DCoJA/yatagarasu-red/README.md

# yatagarasu-red

Kicad file of the shield which is to run ArduPilot on 96Boards.

## File list

Kicad project file

* yatagarasu-fit.pro

Schematic

* [yatagarasu-fit.pdf](./yatagarasu-fit.pdf)

## Videos on youtube of the first flight

* Used DragonBoard 410C (Snapdragon 410E).

### In English

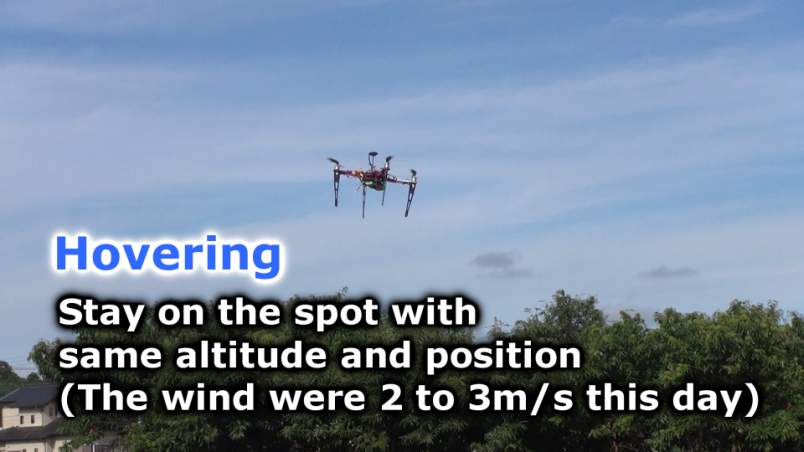
[picture p1: images/yatagarasu4-music-en.png]
(https://www.youtube.com/watch?v=AuMpDXEWkLk)


### In Japanese

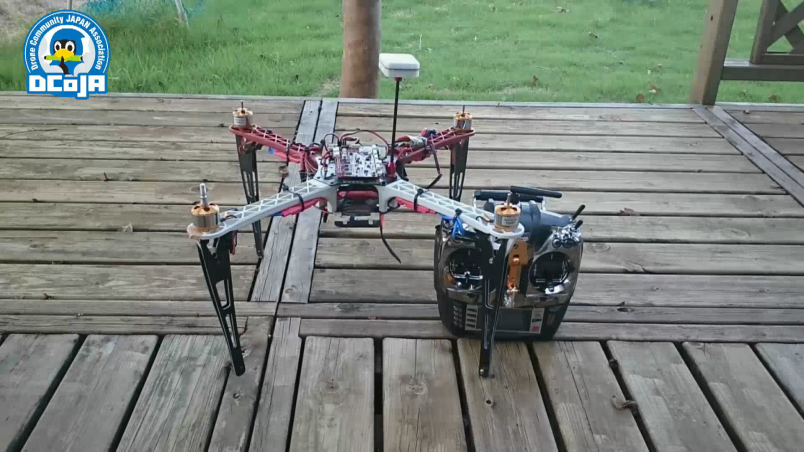
[picture p2: images/yatagarasu4-music-jp.png]
(https://www.youtube.com/watch?v=8HEuyZ0l6P4)


## Images

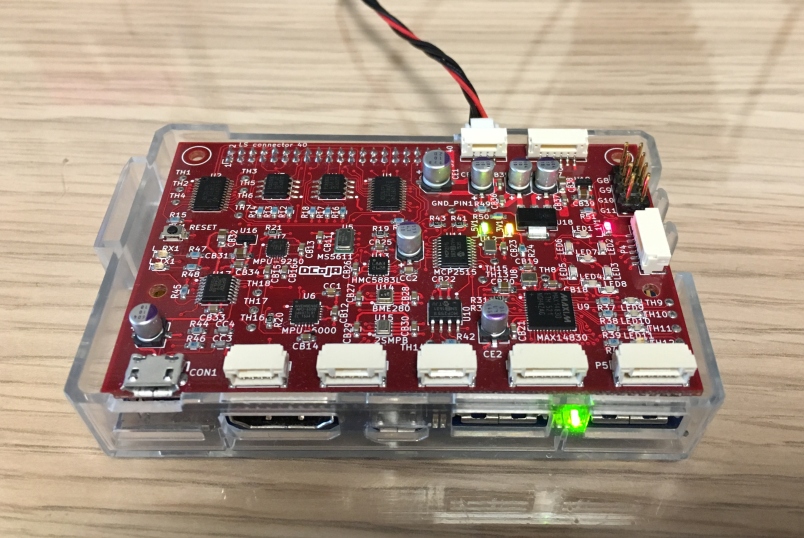
[picture p3: images/yatagarasu-red-LED-mod-804.jpg]
powered-on

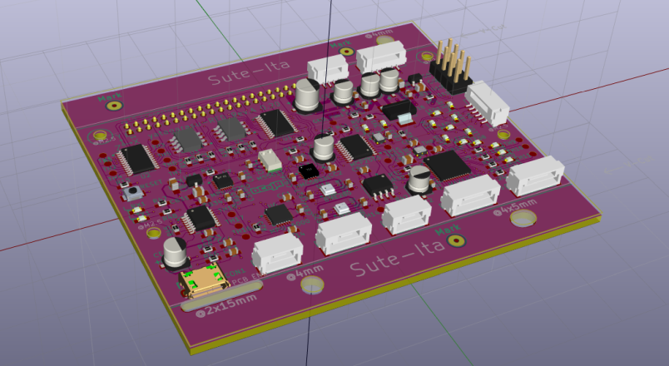
[picture p4: images/3d-top-20170331-25-s.png]
3D-model-top-kicad

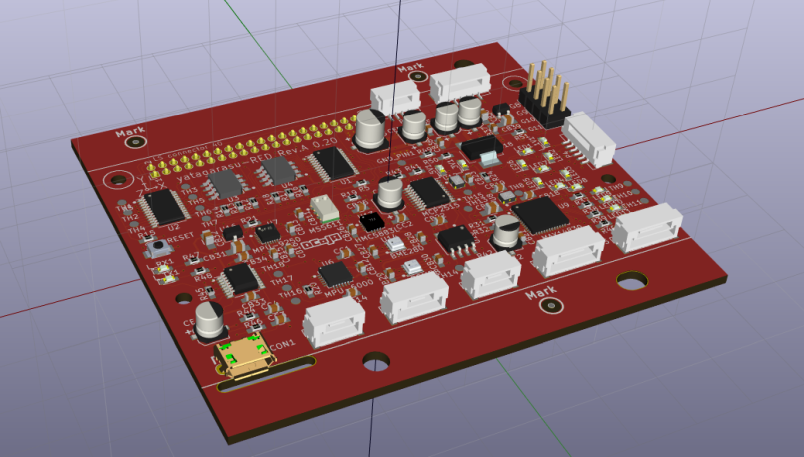
[picture p5: images/3d-top-20170331-25-real-s.png]
3D-model-top-details

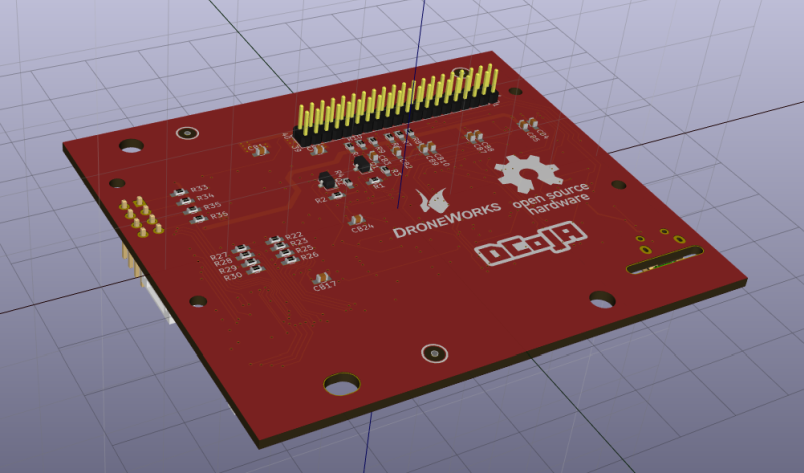
[picture p6: images/3d-bottom-20170331-25-s.png]
3D-model-bottom-kicad

  
PCB Layout  
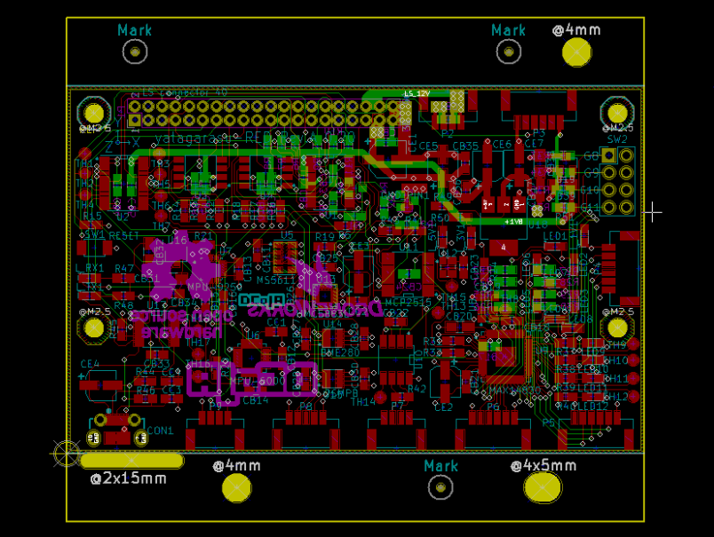
[picture p7: images/kicad-pcbnew-screen-s.png]
kicad-pcbnew

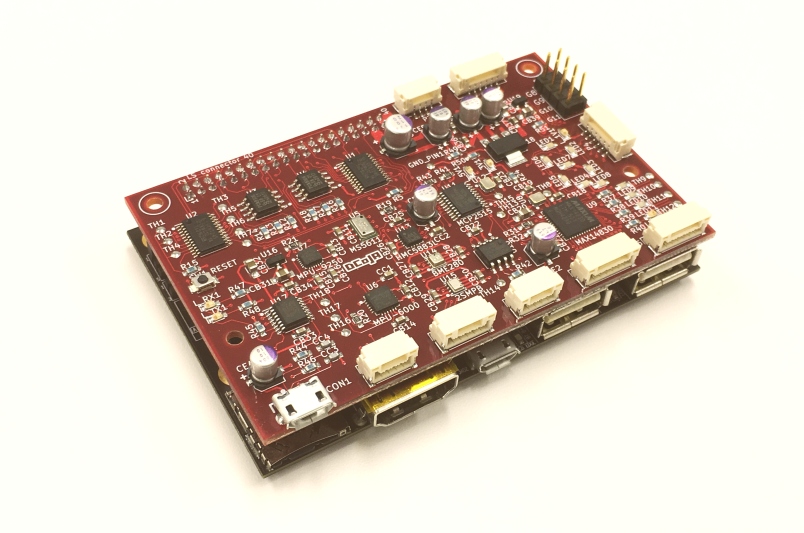
[picture p8: images/yatagarasu-top-front-left-s.jpg]
PCB-TOP-left

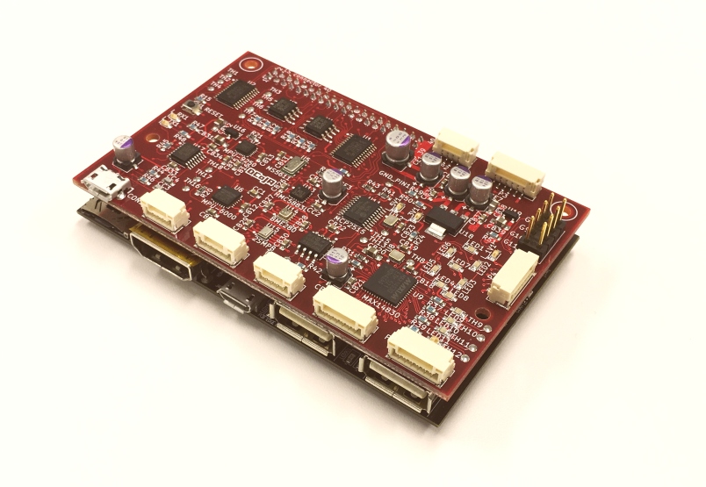
[picture p9: images/yatagarasu-top-front-right-s.jpg]
PCB-TOP-right
