DCoJA/yatagarasu-red/images/3d-bottom-20170331-17-s-s.png

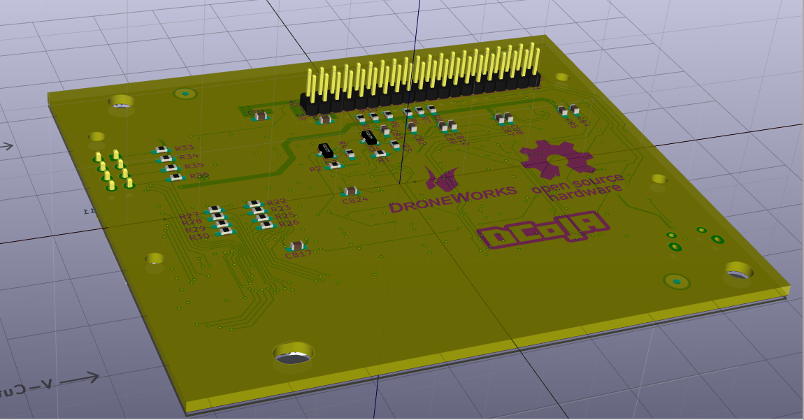
images/3d-bottom-20170331-17-s-s.png
