DCoJA/yatagarasu-red/images/3d-top-20170331-23-1-s-s.jpg

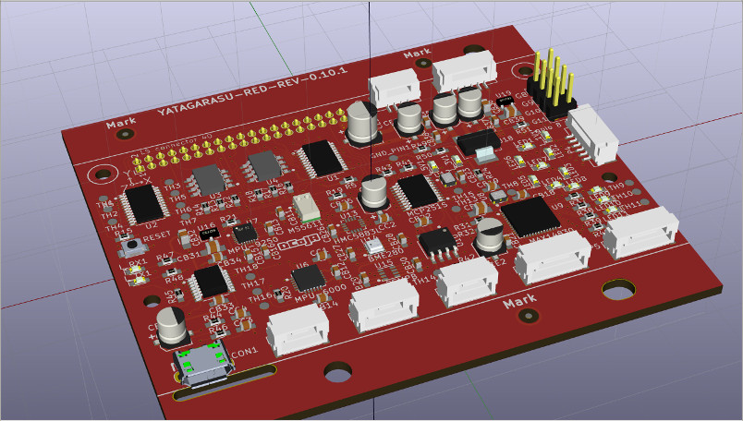
images/3d-top-20170331-23-1-s-s.jpg
