DCoJA/yatagarasu-red/images/yagarasu-red-front-board-g-1-s.jpg

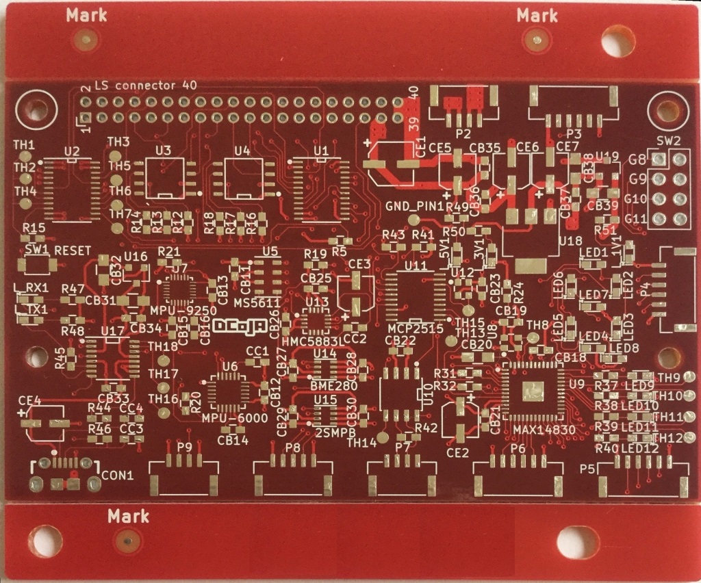
images/yagarasu-red-front-board-g-1-s.jpg
