DCoJA/yatagarasu-red/Console.sch

## KiCad design Console.sch (2017-12-15)

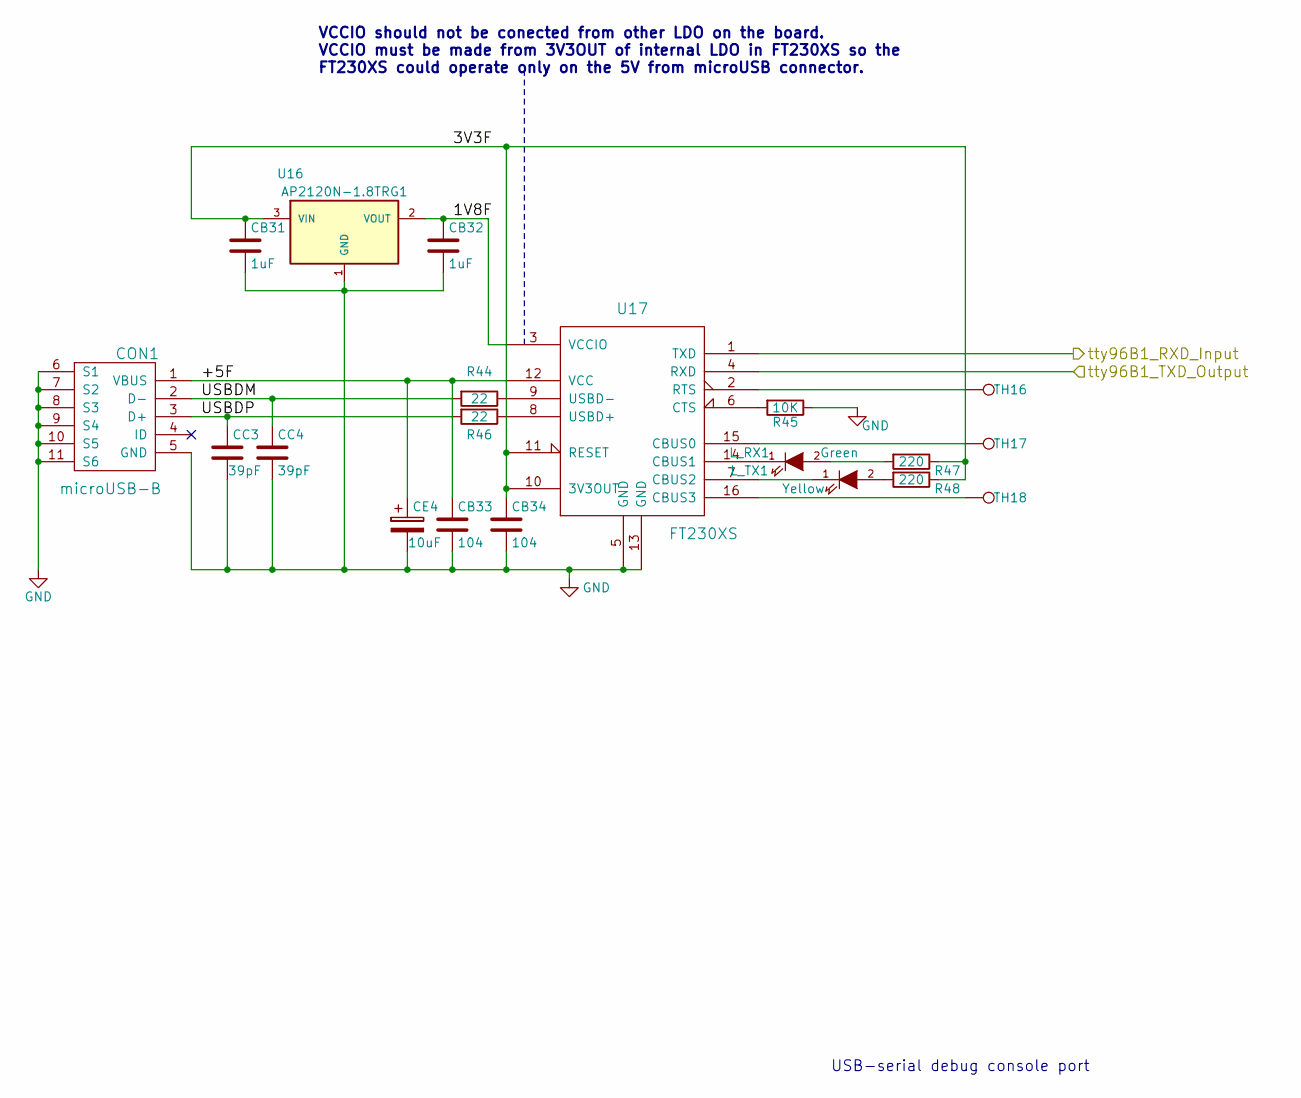
[picture p21: schematic Console.sch]

Parts:
CB31, CB32: 1uF; C_0805_Hand_droneworks
CB33, CB34: 104; C_0603_Hand_droneworks
CC3, CC4: 39pF; C_0603_Hand_droneworks
CE4: 10uF; CP_OS-CON-A5_droneworks
CON1: microUSB-B; USB_Micro-B_Amphenol-10118194-0001LF-C_droneworks
L_RX1: Green; LED_0603_1608mm_droneworks
L_TX1: Yellow; LED_0603_1608mm_droneworks
R44, R46: 22; R_0603_Hand_droneworks
R45: 10K; R_0603_Hand_droneworks
R47, R48: 220; R_0603_Hand_droneworks
TH16: RTS; SolderWirePad_single_1mmPad_droneworks
TH17: CBUS0; SolderWirePad_single_1mmPad_droneworks
TH18: CBUS3; SolderWirePad_single_1mmPad_droneworks
U16: AP2120N-1.8TRG1; SOT-23
U17: FT230XS; SSOP-16_3.9x4.9mm_Pitch0.635mm_droneworks

Connections:
1V8F: CB32.1, U16.2 (VOUT), U17.3 (VCCIO)
3V3F: CB31.1, CB34.1, R47.1, R48.1, U16.3 (VIN), U17.10 (3V3OUT), U17.11 (RESET)
+5F: CB33.1, CE4.1, CON1.1 (VBUS), U17.12 (VCC)
GND: CB31.2, CB32.2, CB33.2, CB34.2, CC3.2, CC4.2, CE4.2, CON1.5 (GND), CON1.6 (S1), CON1.7 (S2), CON1.8 (S3), CON1.9 (S4), CON1.10 (S5), CON1.11 (S6), R45.1, U16.1 (GND), U17.5 (GND), U17.13 (GND)
unnamed: L_RX1.1 (K), U17.14 (CBUS1)
unnamed: L_RX1.2 (A), R47.2
unnamed: L_TX1.1 (K), U17.7 (CBUS2)
unnamed: L_TX1.2 (A), R48.2
unnamed: R44.1, U17.9 (USBD-)
unnamed: R45.2, U17.6 (CTS)
unnamed: R46.1, U17.8 (USBD+)
unnamed: TH16.1, U17.2 (RTS)
unnamed: TH17.1, U17.15 (CBUS0)
unnamed: TH18.1, U17.16 (CBUS3)
USBDM: CC4.1, CON1.2 (D-), R44.2
USBDP: CC3.1, CON1.3 (D+), R46.2
tty96B1_RXD_Input: U17.1 (TXD)
tty96B1_TXD_Output: U17.4 (RXD)

Notes on the sheet:
VCCIO should not be conected from other LDO on the board. VCCIO must be made from 3V3OUT of internal LDO in FT230XS so the FT230XS could operate only on the 5V from microUSB connector.
USB-serial debug console port
