DCoJA/yatagarasu-red/NCP1117s.sch

## KiCad design NCP1117s.sch (2017-12-15)

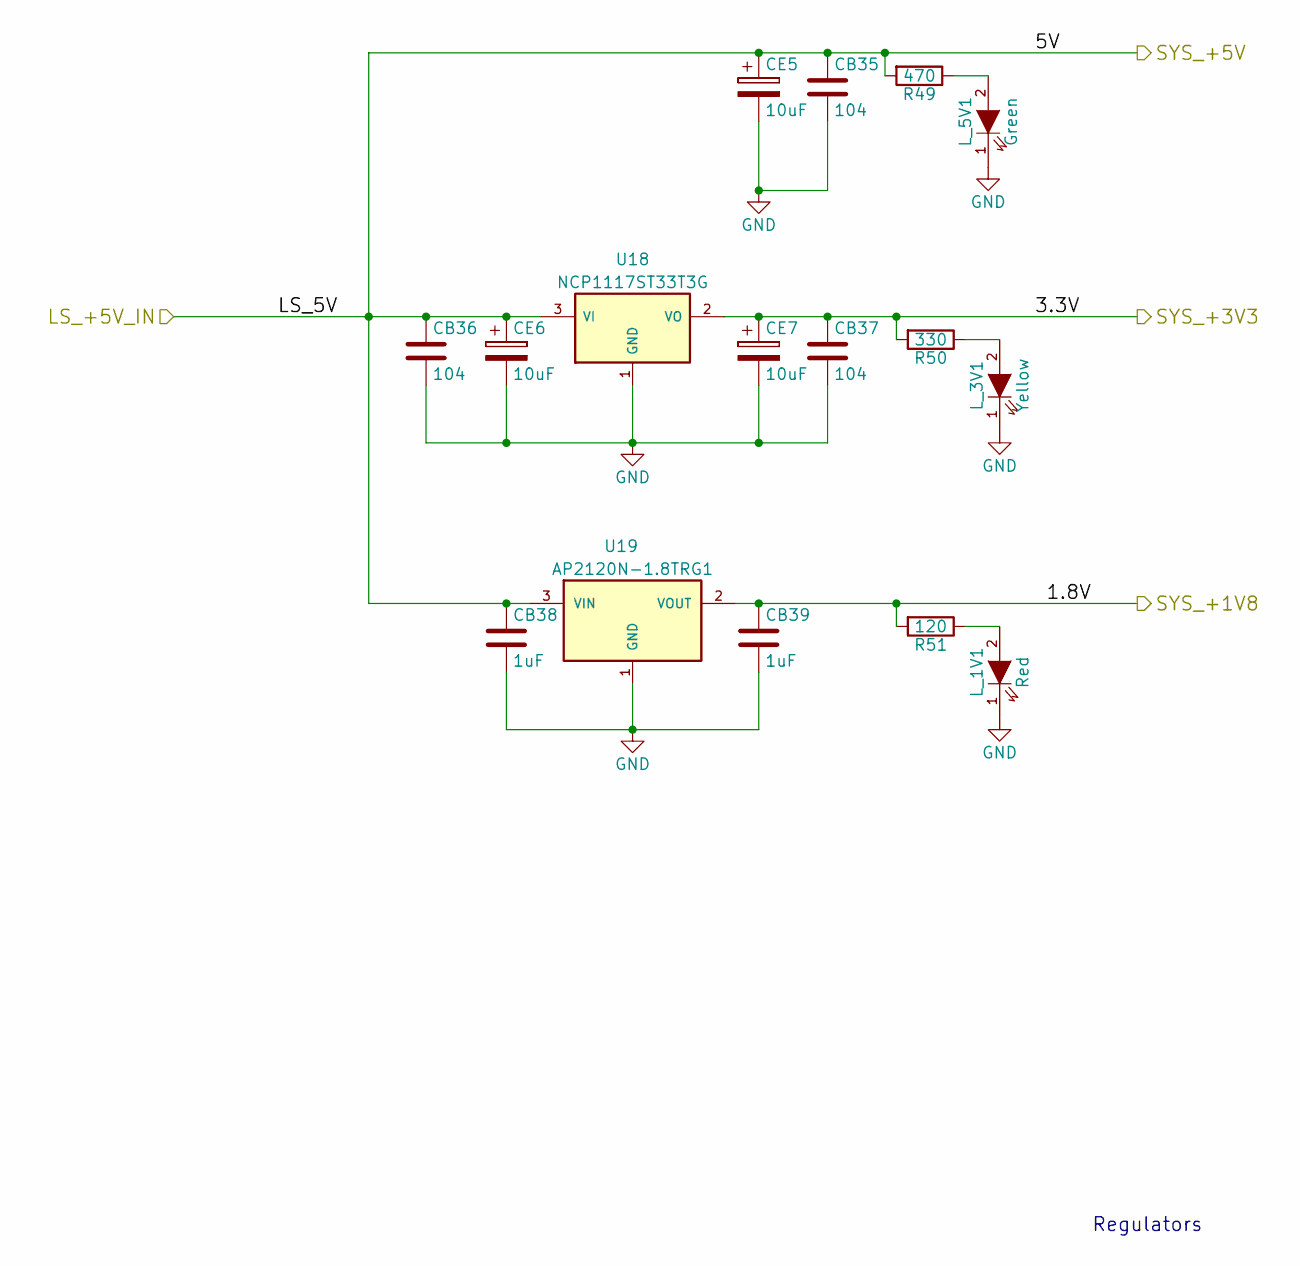
[picture p22: schematic NCP1117s.sch]

Parts:
CB35, CB36, CB37: 104; C_0603_Hand_droneworks
CB38, CB39: 1uF; C_0805_Hand_droneworks
CE5, CE6, CE7: 10uF; CP_OS-CON-A5_droneworks
L_1V1: Red; LED_0603_1608mm_droneworks
L_3V1: Yellow; LED_0603_1608mm_droneworks
L_5V1: Green; LED_0603_1608mm_droneworks
R49: 470; R_0603_Hand_droneworks
R50: 330; R_0603_Hand_droneworks
R51: 120; R_0603_Hand_droneworks
U18: NCP1117ST33T3G; SOT-223
U19: AP2120N-1.8TRG1; SOT-23

Connections:
1.8V: CB39.1, R51.2, U19.2 (VOUT)
3.3V: CB37.1, CE7.1, R50.2, U18.2 (VO)
5V: CB35.1, CB36.1, CB38.1, CE5.1, CE6.1, R49.2, U18.3 (VI), U19.3 (VIN)
GND: CB35.2, CB36.2, CB37.2, CB38.2, CB39.2, CE5.2, CE6.2, CE7.2, L_1V1.1 (K), L_3V1.1 (K), L_5V1.1 (K), U18.1 (GND), U19.1 (GND)
unnamed: L_1V1.2 (A), R51.1
unnamed: L_3V1.2 (A), R50.1
unnamed: L_5V1.2 (A), R49.1

Notes on the sheet:
Regulators
