DCoJA/yatagarasu-red/can.sch

## KiCad design can.sch (2017-12-15)

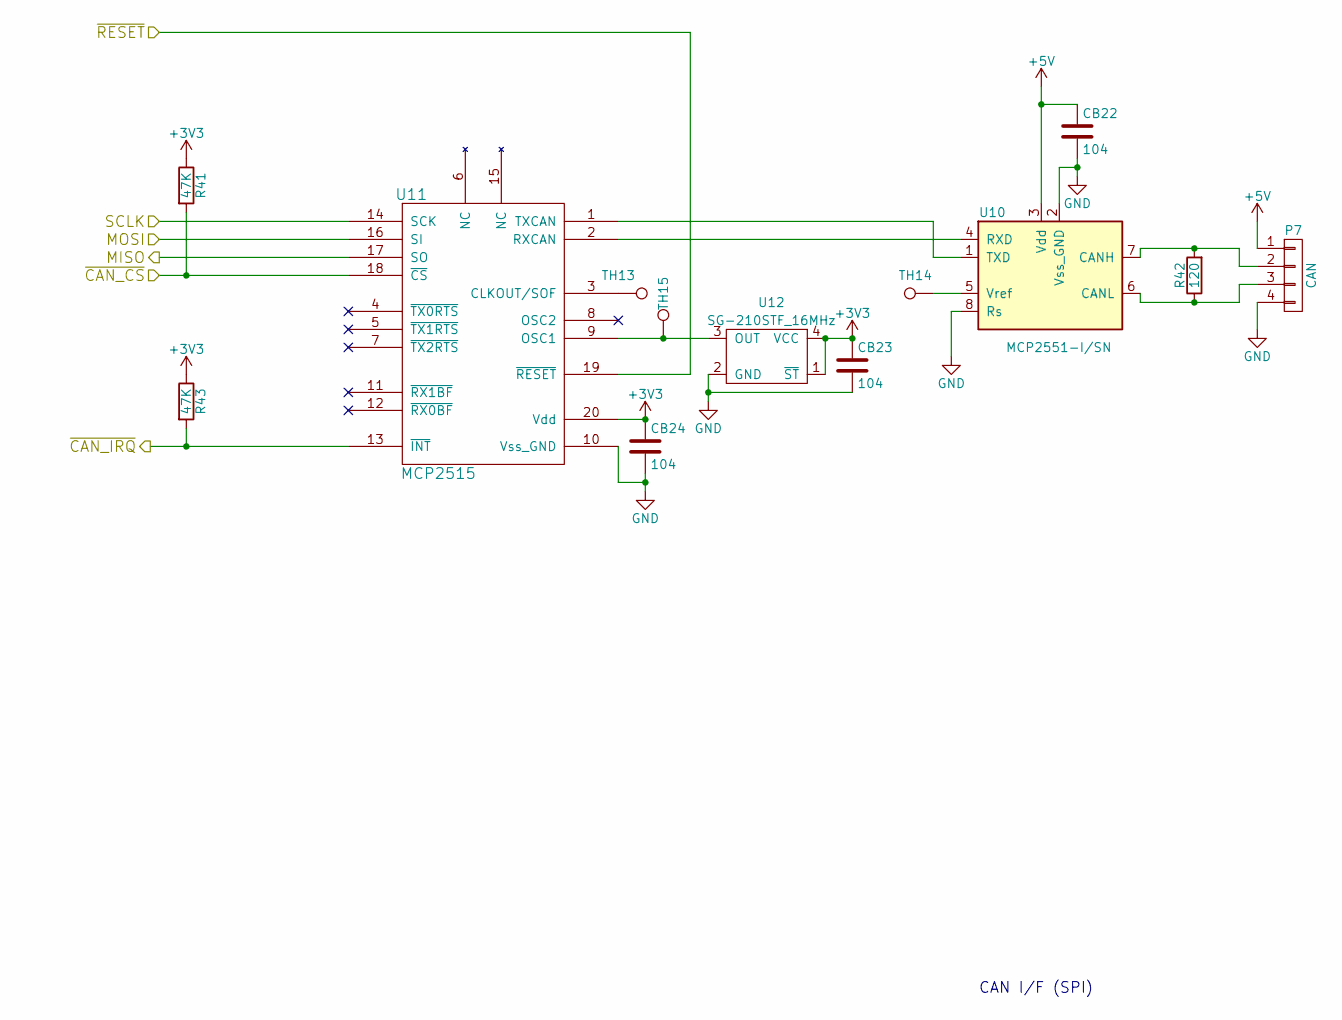
[picture p23: schematic can.sch]

Parts:
CB22, CB23, CB24: 104; C_0603_Hand_droneworks
P7: CAN; GH_4P_side_droneworks
R41, R43: 47K; R_0603_Hand_droneworks
R42: 120; R_0603_Hand_droneworks
TH13: CLKOUT; SolderWirePad_single_1mmPad_droneworks
TH14: Vref; SolderWirePad_single_1mmPad_droneworks
TH15: 16MHz; SolderWirePad_single_1mmPad_droneworks
U10: MCP2551-I/SN; SOIC-8_3.9x4.9mm_MCP2551_droneworks
U11: MCP2515; TSSOP-20_4.4x6.5mm_MCP2515_droneworks
U12: SG-210STF_16MHz; SG-210STF_droneworks

Connections:
+3V3: CB23.1, CB24.1, R41.1, R43.1, U11.20 (Vdd), U12.1 (~ST), U12.4 (VCC)
+5V: CB22.1, P7.1, U10.3 (Vdd)
GND: CB22.2, CB23.2, CB24.2, P7.4, U10.2 (Vss_GND), U10.8 (Rs), U11.10 (Vss_GND), U12.2 (GND)
MISO: U11.17 (SO)
MOSI: U11.16 (SI)
unnamed: P7.2, R42.2, U10.7 (CANH)
unnamed: P7.3, R42.1, U10.6 (CANL)
unnamed: TH13.1, U11.3 (CLKOUT/SOF)
unnamed: TH14.1, U10.5 (Vref)
unnamed: TH15.1, U11.9 (OSC1), U12.3 (OUT)
unnamed: U10.1 (TXD), U11.1 (TXCAN)
unnamed: U10.4 (RXD), U11.2 (RXCAN)
SCLK: U11.14 (SCK)
~CAN_CS: R41.2, U11.18 (~CS)
~CAN_IRQ: R43.2, U11.13 (~INT)
~RESET: U11.19 (~RESET)

Notes on the sheet:
CAN I/F (SPI)
