DCoJA/yatagarasu-red/i2c0.sch

## KiCad design i2c0.sch (2017-12-15)

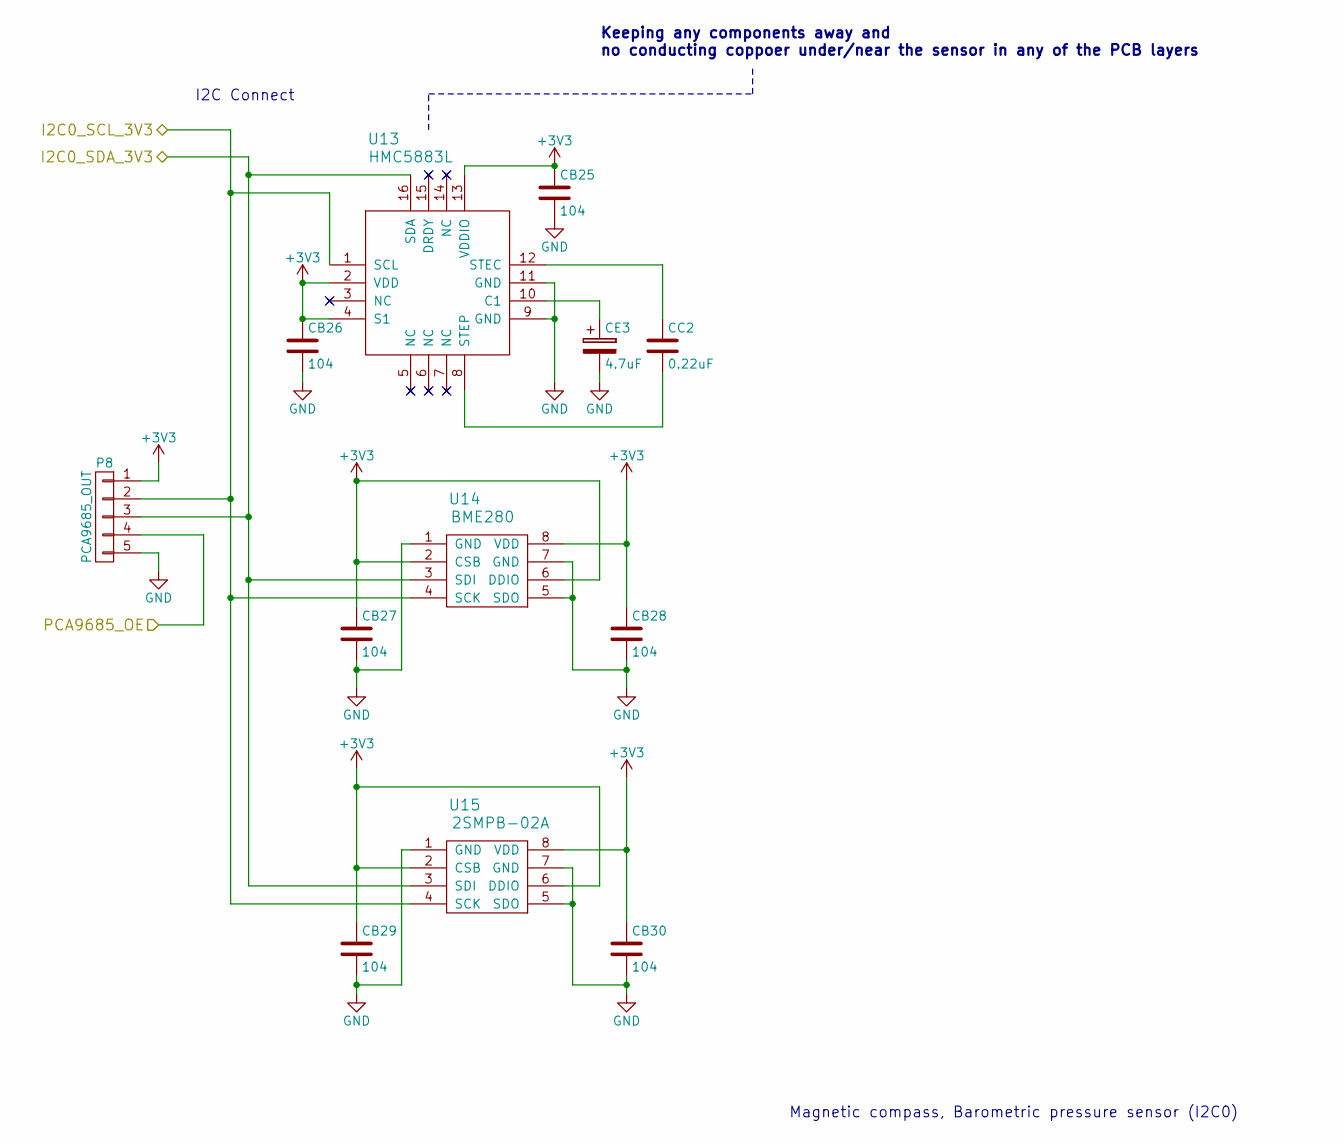
[picture p24: schematic i2c0.sch]

Parts:
CB25, CB26, CB27, CB28, CB29, CB30: 104; C_0603_Hand_droneworks
CC2: 0.22uF; C_0603_Hand_droneworks
CE3: 4.7uF; CP_OS-CON-A5_droneworks
P8: PCA9685_OUT; GH_5P_side_droneworks
U13: HMC5883L; LPCC-16_HMC5883L_droneworks
U14: BME280; LGA-8_BME280_droneworks
U15: 2SMPB-02A; LGA-8_2SMPB-02A_droneworks

Connections:
+3V3: CB25.1, CB26.1, CB27.1, CB28.1, CB29.1, CB30.1, P8.1, U13.2 (VDD), U13.4 (S1), U13.13 (VDDIO), U14.2 (CSB), U14.6 (DDIO), U14.8 (VDD), U15.2 (CSB), U15.6 (DDIO), U15.8 (VDD)
GND: CB25.2, CB26.2, CB27.2, CB28.2, CB29.2, CB30.2, CE3.2, P8.5, U13.9 (GND), U13.11 (GND), U14.1 (GND), U14.5 (SDO), U14.7 (GND), U15.1 (GND), U15.5 (SDO), U15.7 (GND)
I2C0_SCL_3V3: P8.2, U13.1 (SCL), U14.4 (SCK), U15.4 (SCK)
I2C0_SDA_3V3: P8.3, U13.16 (SDA), U14.3 (SDI), U15.3 (SDI)
unnamed: CC2.1, U13.12 (STEC)
unnamed: CC2.2, U13.8 (STEP)
unnamed: CE3.1, U13.10 (C1)
PCA9685_OE: P8.4

Notes on the sheet:
I2C Connect
Keeping any components away and no conducting coppoer under/near the sensor in any of the PCB layers
Magnetic compass, Barometric pressure sensor (I2C0)
