DCoJA/yatagarasu-red/max.sch

## KiCad design max.sch (2017-12-15)

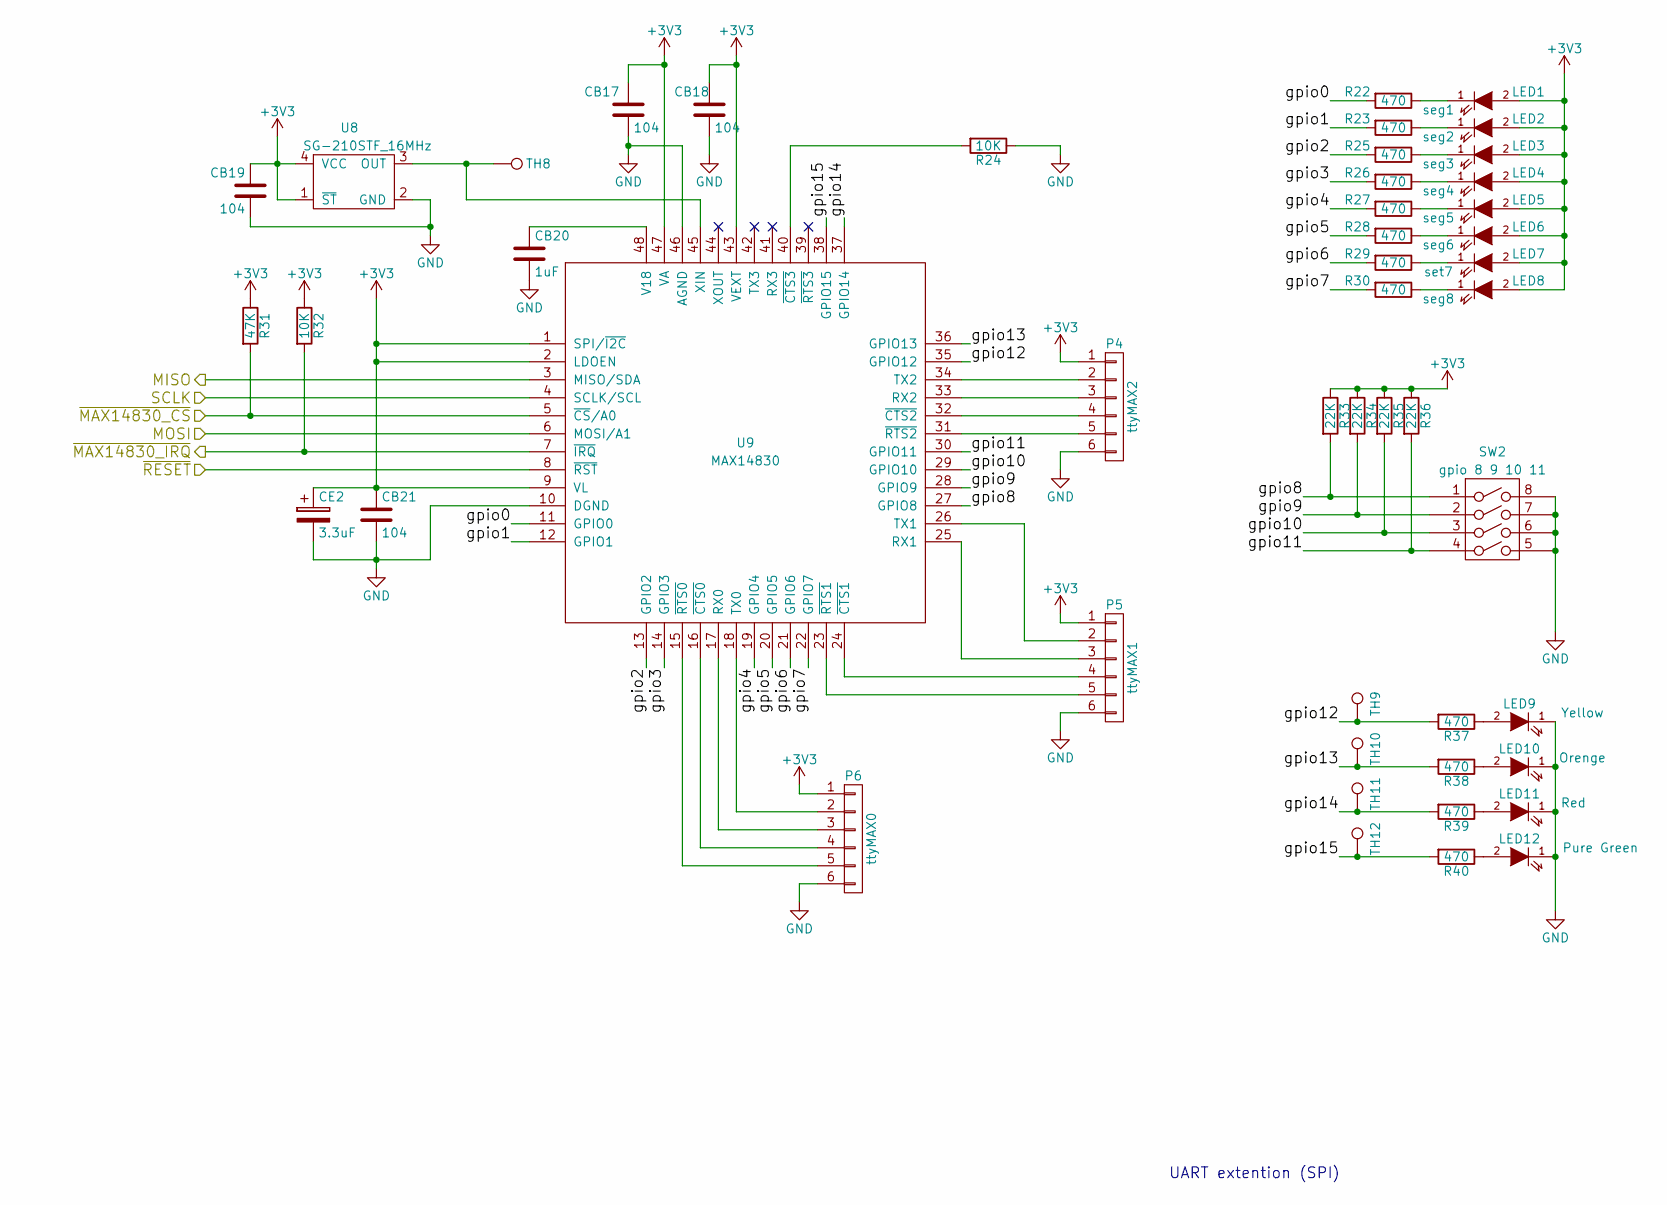
[picture p25: schematic max.sch]

Parts:
CB17, CB18, CB19, CB21: 104; C_0603_Hand_droneworks
CB20: 1uF; C_0805_Hand_droneworks
CE2: 3.3uF; CP_OS-CON-A5_droneworks
LED1: seg1; LED_0603_1608mm_droneworks
LED2: seg2; LED_0603_1608mm_droneworks
LED3: seg3; LED_0603_1608mm_droneworks
LED4: seg4; LED_0603_1608mm_droneworks
LED5: seg5; LED_0603_1608mm_droneworks
LED6: seg6; LED_0603_1608mm_droneworks
LED7: set7; LED_0603_1608mm_droneworks
LED8: seg8; LED_0603_1608mm_droneworks
LED9: Yellow; LED_0603_1608mm_droneworks
LED10: Orenge; LED_0603_1608mm_droneworks
LED11: Red; LED_0603_1608mm_droneworks
LED12: Pure Green; LED_0603_1608mm_droneworks
P4: ttyMAX2; GH_6P_side_droneworks
P5: ttyMAX1; GH_6P_side_droneworks
P6: ttyMAX0; GH_6P_side_droneworks
R22, R23, R25, R26, R27, R28, R29, R30, R37, R38, R39, R40: 470; R_0603_Hand_droneworks
R24, R32: 10K; R_0603_Hand_droneworks
R31: 47K; R_0603_Hand_droneworks
R33, R34, R35, R36: 22K; R_0603_Hand_droneworks
SW2: gpio 8 9 10 11; Pin_Header_Straight_2x04_Pitch2.54mm_Jumper_droneworks
TH8: 16MHz; SolderWirePad_single_1mmPad_droneworks
TH9: GPIO12; SolderWirePad_single_1mmPad_droneworks
TH10: GPIO13; SolderWirePad_single_1mmPad_droneworks
TH11: GPIO14; SolderWirePad_single_1mmPad_droneworks
TH12: GPIO15; SolderWirePad_single_1mmPad_droneworks
U8: SG-210STF_16MHz; SG-210STF_droneworks
U9: MAX14830; QFN-48-1EP_7x7_MAX1480_droneworks

Connections:
+3V3: CB17.1, CB18.1, CB19.1, CB21.1, CE2.1, LED1.2 (A), LED2.2 (A), LED3.2 (A), LED4.2 (A), LED5.2 (A), LED6.2 (A), LED7.2 (A), LED8.2 (A), P4.1, P5.1, P6.1, R31.1, R32.1, R33.1, R34.1, R35.1, R36.1, U8.1 (~ST), U8.4 (VCC), U9.1 (SPI/~I2C), U9.2 (LDOEN), U9.9 (VL), U9.43 (VEXT), U9.47 (VA)
GND: CB17.2, CB18.2, CB19.2, CB20.2, CB21.2, CE2.2, LED9.1 (K), LED10.1 (K), LED11.1 (K), LED12.1 (K), P4.6, P5.6, P6.6, R24.1, SW2.5, SW2.6, SW2.7, SW2.8, U8.2 (GND), U9.10 (DGND), U9.46 (AGND)
MISO: U9.3 (MISO/SDA)
MOSI: U9.6 (MOSI/A1)
unnamed: CB20.1, U9.48 (V18)
unnamed: LED1.1 (K), R22.1
unnamed: LED2.1 (K), R23.1
unnamed: LED3.1 (K), R25.1
unnamed: LED4.1 (K), R26.1
unnamed: LED5.1 (K), R27.1
unnamed: LED6.1 (K), R28.1
unnamed: LED7.1 (K), R29.1
unnamed: LED8.1 (K), R30.1
unnamed: LED9.2 (A), R37.1
unnamed: LED10.2 (A), R38.1
unnamed: LED11.2 (A), R39.1
unnamed: LED12.2 (A), R40.1
unnamed: P4.2, U9.34 (TX2)
unnamed: P4.3, U9.33 (RX2)
unnamed: P4.4, U9.32 (~CTS2)
unnamed: P4.5, U9.31 (~RTS2)
unnamed: P5.2, U9.26 (TX1)
unnamed: P5.3, U9.25 (RX1)
unnamed: P5.4, U9.24 (~CTS1)
unnamed: P5.5, U9.23 (~RTS1)
unnamed: P6.2, U9.18 (TX0)
unnamed: P6.3, U9.17 (RX0)
unnamed: P6.4, U9.16 (~CTS0)
unnamed: P6.5, U9.15 (~RTS0)
unnamed: R24.2, U9.40 (~CTS3)
unnamed: TH8.1, U8.3 (OUT), U9.45 (XIN)
SCLK: U9.4 (SCLK/SCL)
gpio0: R22.2, U9.11 (GPIO0)
gpio1: R23.2, U9.12 (GPIO1)
gpio2: R25.2, U9.13 (GPIO2)
gpio3: R26.2, U9.14 (GPIO3)
gpio4: R27.2, U9.19 (GPIO4)
gpio5: R28.2, U9.20 (GPIO5)
gpio6: R29.2, U9.21 (GPIO6)
gpio7: R30.2, U9.22 (GPIO7)
gpio8: R33.2, SW2.1, U9.27 (GPIO8)
gpio9: R34.2, SW2.2, U9.28 (GPIO9)
gpio10: R35.2, SW2.3, U9.29 (GPIO10)
gpio11: R36.2, SW2.4, U9.30 (GPIO11)
gpio12: R37.2, TH9.1, U9.35 (GPIO12)
gpio13: R38.2, TH10.1, U9.36 (GPIO13)
gpio14: R39.2, TH11.1, U9.37 (GPIO14)
gpio15: R40.2, TH12.1, U9.38 (GPIO15)
~MAX14830_CS: R31.2, U9.5 (~CS~/A0)
~MAX14830_IRQ: R32.2, U9.7 (~IRQ)
~RESET: U9.8 (~RST)

Notes on the sheet:
UART extention (SPI)
