DCoJA/yatagarasu-red/spi.sch

## KiCad design spi.sch (2017-12-15)

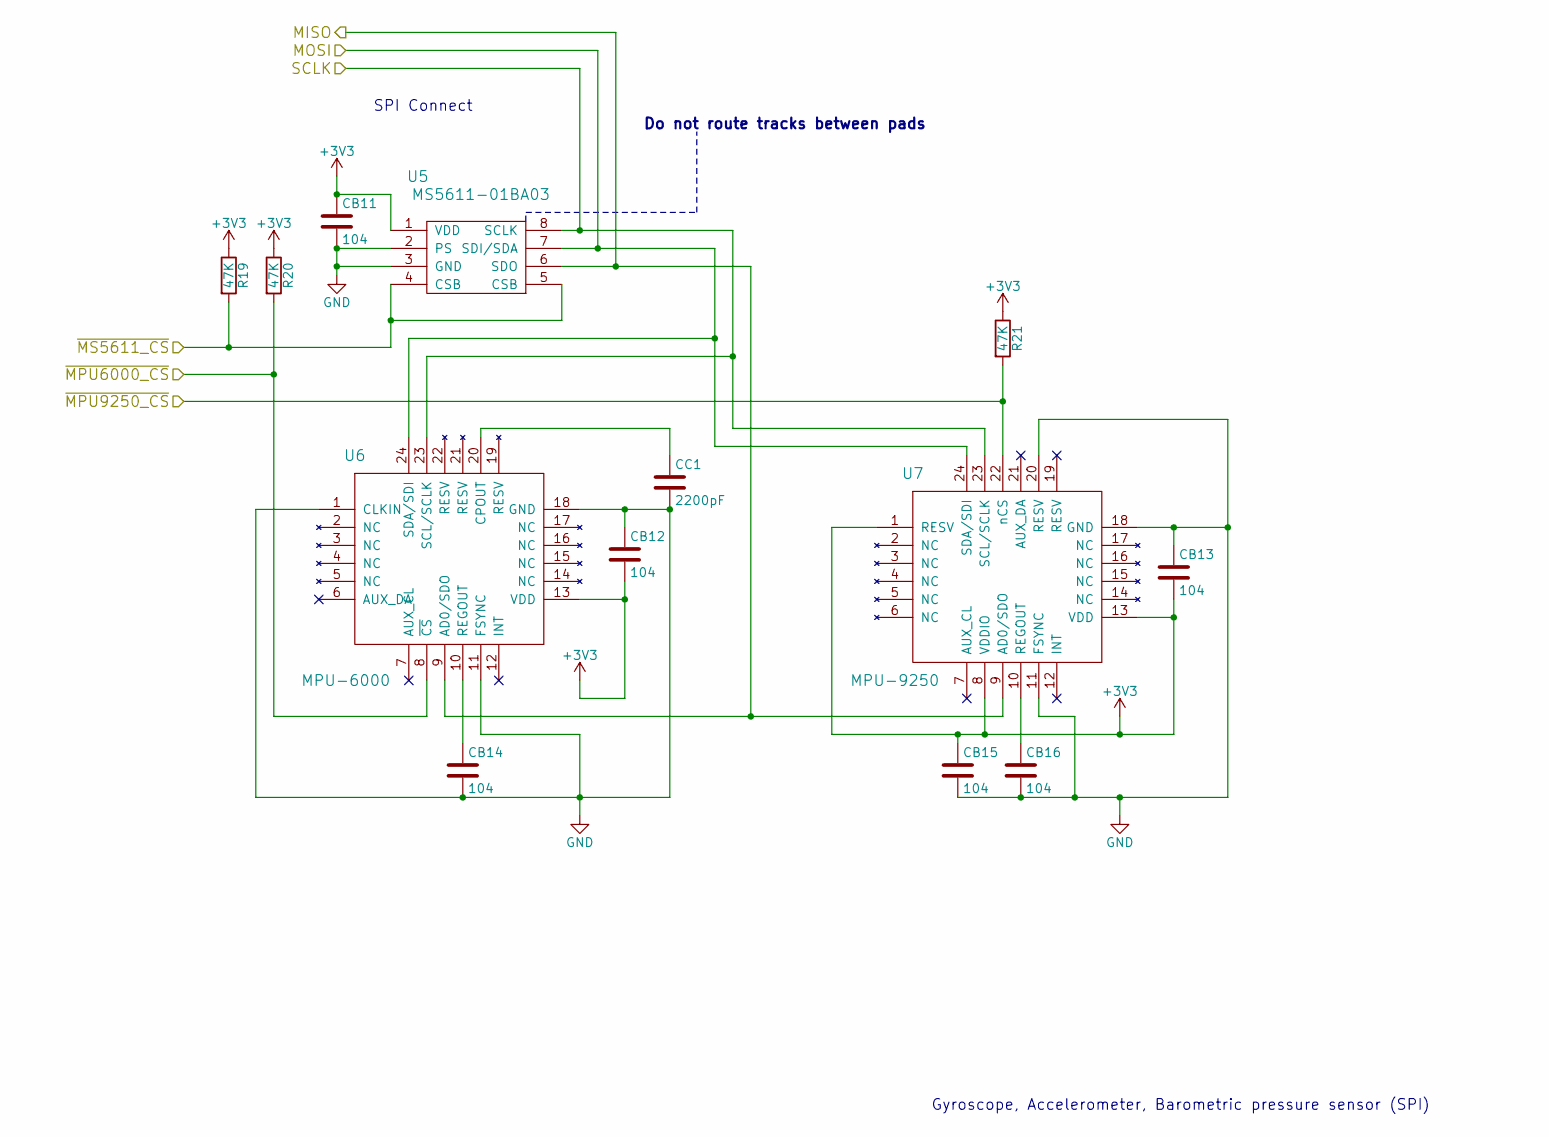
[picture p26: schematic spi.sch]

Parts:
CB11, CB12, CB13, CB14, CB15, CB16: 104; C_0603_Hand_droneworks
CC1: 2200pF; C_0603_Hand_droneworks
R19, R20, R21: 47K; R_0603_Hand_droneworks
U5: MS5611-01BA03; MS5611-01BA03_droneworks
U6: MPU-6000; QFN-4-24_MPU-90X0_droneworks
U7: MPU-9250; QFN-3-24_MPU-9250_droneworks

Connections:
+3V3: CB11.1, CB12.2, CB13.2, CB15.1, R19.1, R20.1, R21.1, U5.1 (VDD), U6.13 (VDD), U7.1 (RESV), U7.8 (VDDIO), U7.13 (VDD)
GND: CB11.2, CB12.1, CB13.1, CB14.2, CB15.2, CB16.2, CC1.2, U5.2 (PS), U5.3 (GND), U6.1 (CLKIN), U6.11 (FSYNC), U6.18 (GND), U7.11 (FSYNC), U7.18 (GND), U7.20 (RESV)
MISO: U5.6 (SDO), U6.9 (AD0/SDO), U7.9 (AD0/SDO)
MOSI: U5.7 (SDI/SDA), U6.24 (SDA/SDI), U7.24 (SDA/SDI)
unnamed: CB14.1, U6.10 (REGOUT)
unnamed: CB16.1, U7.10 (REGOUT)
unnamed: CC1.1, U6.20 (CPOUT)
SCLK: U5.8 (SCLK), U6.23 (SCL/SCLK), U7.23 (SCL/SCLK)
~MPU6000_CS: R20.2, U6.8 (~CS)
~MPU9250_CS: R21.2, U7.22 (nCS)
~MS5611_CS: R19.2, U5.4 (CSB), U5.5 (CSB)

Notes on the sheet:
SPI Connect
Do not route tracks between pads
Gyroscope, Accelerometer, Barometric pressure sensor (SPI)
