DCoJA/yatagarasu-red/yatagarasu-fit.sch

## KiCad design yatagarasu-fit.sch (2017-12-15)

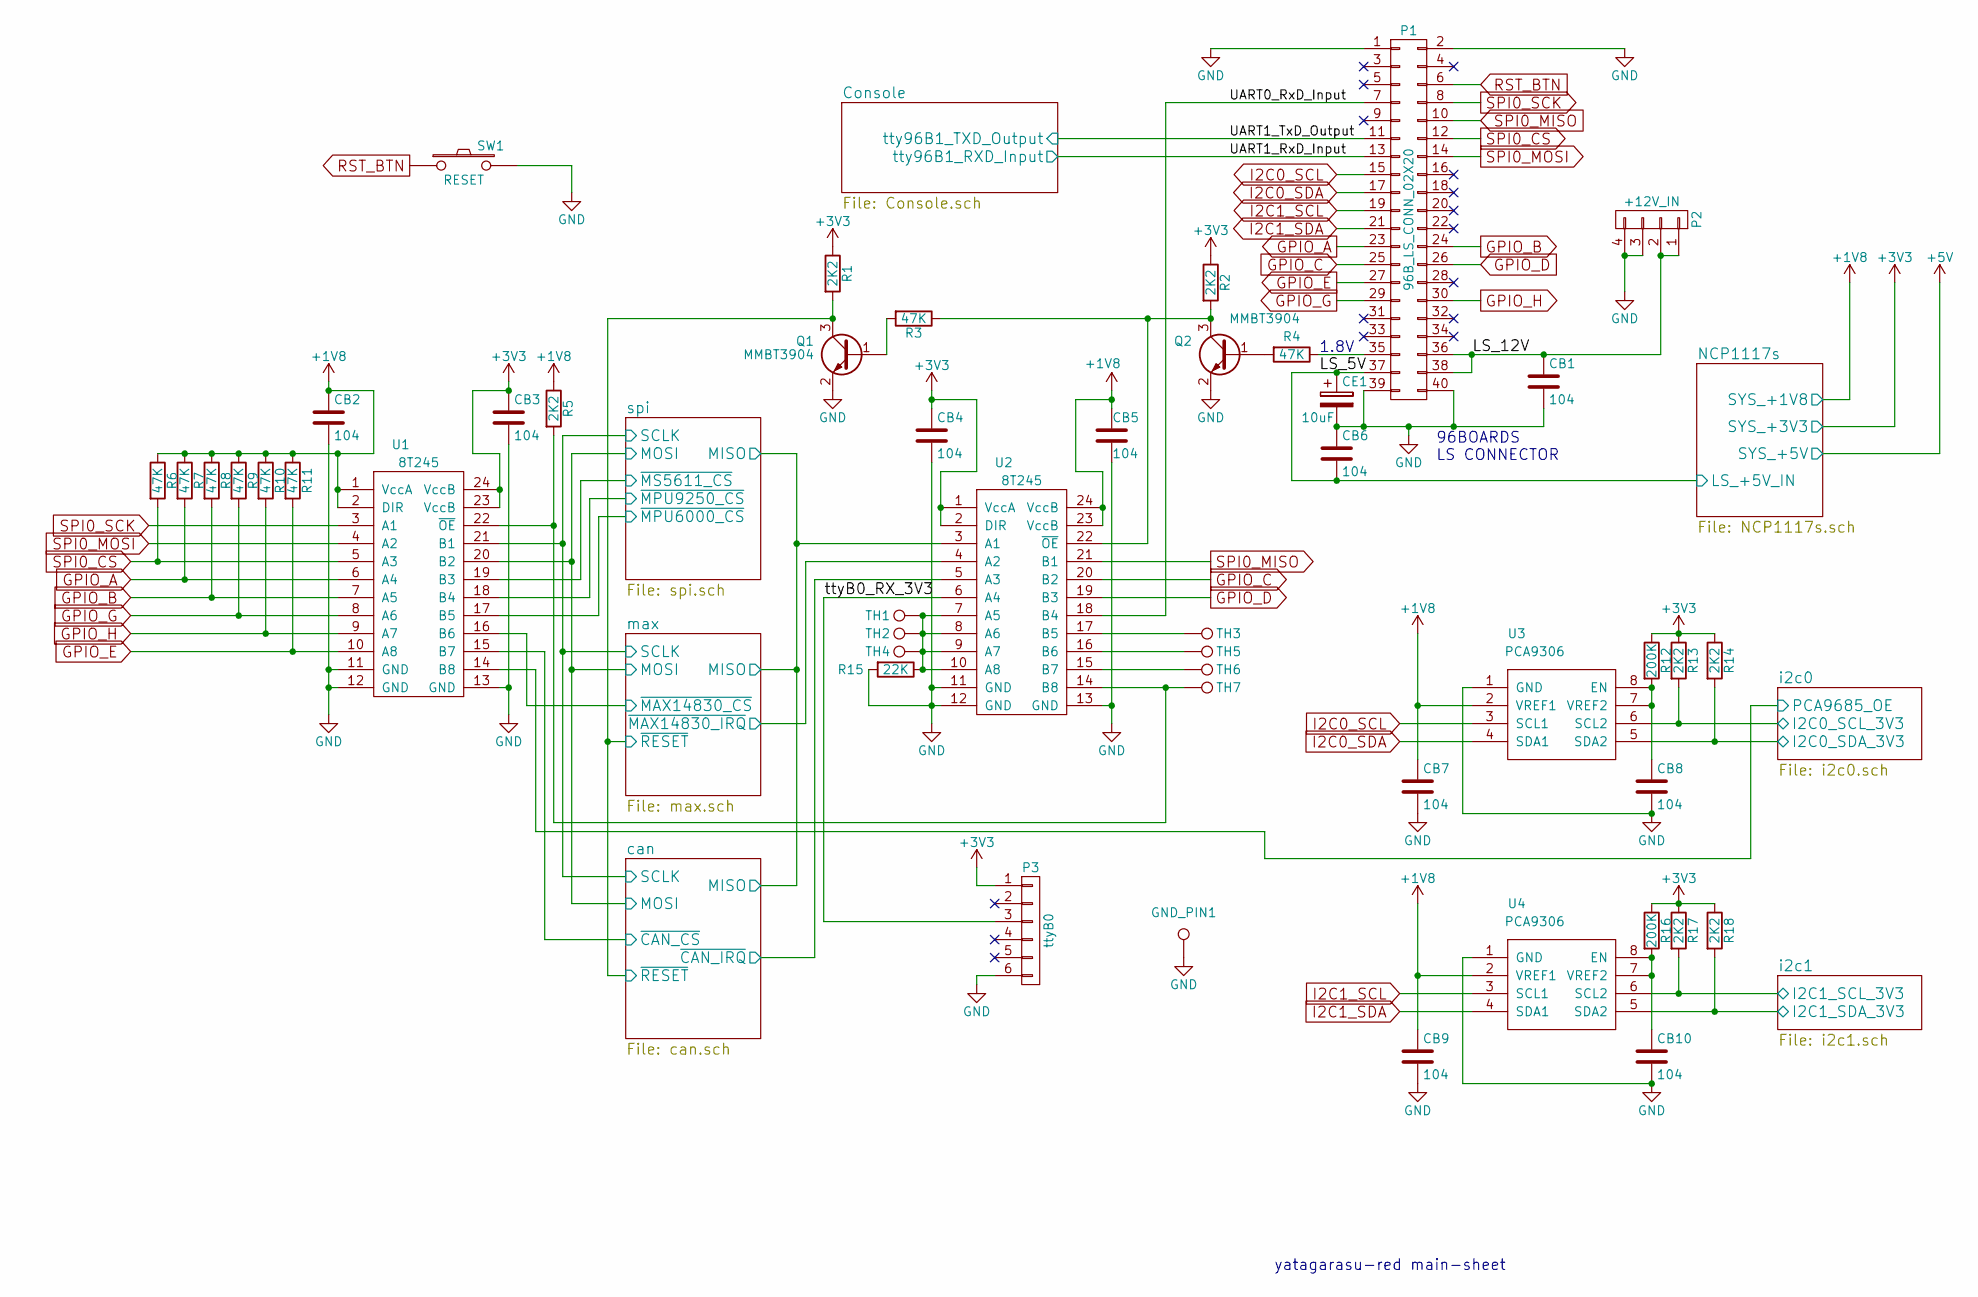
[picture p27: schematic yatagarasu-fit.sch]

Parts:
CB1, CB2, CB3, CB4, CB5, CB6, CB7, CB8, CB9, CB10: 104; C_0603_Hand_droneworks
CE1: 10uF; CP_OS-CON-B6_droneworks
GND_PIN1: GND; SolderWirePad_single_1mmPad_droneworks
P1: 96B_LS_CONN_02X20; Socket_Strip_Straight_2x20_Pitch2mm_droneworks
P2: +12V_IN; GH_4P_side_droneworks
P3: ttyB0; GH_6P_side_droneworks
Q1, Q2: MMBT3904; SOT-23
R1, R2, R5, R13, R14, R17, R18: 2K2; R_0603_Hand_droneworks
R3, R4, R6, R7, R8, R9, R10, R11: 47K; R_0603_Hand_droneworks
R12, R16: 200K; R_0603_Hand_droneworks
R15: 22K; R_0603_Hand_droneworks
SW1: RESET; SW2-2.6-3.0X2.5X1.2+0.4MM_droneworks
TH1: A5; SolderWirePad_single_1mmPad_droneworks
TH2: A6; SolderWirePad_single_1mmPad_droneworks
TH3: B5; SolderWirePad_single_1mmPad_droneworks
TH4: A7; SolderWirePad_single_1mmPad_droneworks
TH5: B6; SolderWirePad_single_1mmPad_droneworks
TH6: B7; SolderWirePad_single_1mmPad_droneworks
TH7: B8; SolderWirePad_single_1mmPad_droneworks
U1, U2: 8T245; TSSOP-24_4.4x7.8mm_Pitch0.65mm_droneworks
U3, U4: PCA9306; SOIC-8-PCA9306_droneworks

Connections:
+1V8: CB2.1, CB5.1, CB7.1, CB9.1, R5.1, R6.1, R7.1, R8.1, R9.1, R10.1, R11.1, U1.1 (VccA), U1.2 (DIR), U2.23 (VccB), U2.24 (VccB), U3.2 (VREF1), U4.2 (VREF1)
+3V3: CB3.1, CB4.1, P3.1, R1.1, R2.1, R12.1, R13.1, R14.1, R16.1, R17.1, R18.1, U1.23 (VccB), U1.24 (VccB), U2.1 (VccA), U2.2 (DIR)
GND: CB1.2, CB2.2, CB3.2, CB4.2, CB5.2, CB6.1, CB7.2, CB8.2, CB9.2, CB10.2, CE1.2, GND_PIN1.1, P1.1, P1.2, P1.39, P1.40, P2.3, P2.4, P3.6, Q1.2 (E), Q2.2 (E), R15.2, SW1.2, U1.11 (GND), U1.12 (GND), U1.13 (GND), U2.11 (GND), U2.12 (GND), U2.13 (GND), U3.1 (GND), U4.1 (GND)
GPIO_A: P1.23, R7.2, U1.6 (A4)
GPIO_B: P1.24, R8.2, U1.7 (A5)
GPIO_C: P1.25, U2.20 (B2)
GPIO_D: P1.26, U2.19 (B3)
GPIO_E: P1.27, R11.2, U1.10 (A8)
GPIO_G: P1.29, R9.2, U1.8 (A6)
GPIO_H: P1.30, R10.2, U1.9 (A7)
I2C0_SCL: P1.15, U3.3 (SCL1)
I2C0_SCL_3V3: R13.2, U3.6 (SCL2)
I2C0_SDA: P1.17, U3.4 (SDA1)
I2C0_SDA_3V3: R14.2, U3.5 (SDA2)
I2C1_SCL: P1.19, U4.3 (SCL1)
I2C1_SCL_3V3: R17.2, U4.6 (SCL2)
I2C1_SDA: P1.21, U4.4 (SDA1)
I2C1_SDA_3V3: R18.2, U4.5 (SDA2)
LS_5V: CB6.2, CE1.1, P1.37
LS_12V: CB1.1, P1.36, P1.38, P2.1, P2.2
MISO: U2.3 (A1)
MOSI: U1.20 (B2)
unnamed: CB8.1, R12.2, U3.7 (VREF2), U3.8 (EN)
unnamed: CB10.1, R16.2, U4.7 (VREF2), U4.8 (EN)
unnamed: P1.35, R4.1
unnamed: Q1.1 (B), R3.2
unnamed: Q2.1 (B), R4.2
unnamed: Q2.3 (C), R2.2, R3.1, U2.22 (~OE)
unnamed: R5.2, TH7.1, U1.22 (~OE), U2.14 (B8)
unnamed: R15.1, TH1.1, TH2.1, TH4.1, U2.7 (A5), U2.8 (A6), U2.9 (A7), U2.10 (A8)
unnamed: TH3.1, U2.17 (B5)
unnamed: TH5.1, U2.16 (B6)
unnamed: TH6.1, U2.15 (B7)
PCA9685_OE: U1.14 (B8)
RST_BTN: P1.6, SW1.1
SCLK: U1.21 (B1)
SPI0_CS: P1.12, R6.2, U1.5 (A3)
SPI0_MISO: P1.10, U2.21 (B1)
SPI0_MOSI: P1.14, U1.4 (A2)
SPI0_SCK: P1.8, U1.3 (A1)
UART0_RxD_Input: P1.7, U2.18 (B4)
UART1_RxD_Input: P1.13
UART1_TxD_Output: P1.11
ttyB0_RX_3V3: P3.3, U2.6 (A4)
~CAN_CS: U1.15 (B7)
~CAN_IRQ: U2.5 (A3)
~MAX14830_CS: U1.16 (B6)
~MAX14830_IRQ: U2.4 (A2)
~MPU6000_CS: U1.17 (B5)
~MPU9250_CS: U1.18 (B4)
~MS5611_CS: U1.19 (B3)
~RESET: Q1.3 (C), R1.2

Notes on the sheet:
96BOARDS LS CONNECTOR
1.8V
yatagarasu-red main-sheet
