DCoJA/yatagarasu-red/(commit log)

2017-05-16 Added to git
    [Console.sch, NCP1117s.sch, can.sch, i2c0.sch, i2c1.sch, max.sch, spi.sch, yatagarasu-fit.sch]
2017-05-22 Regenerated pdf file of schematic
    [Console.sch, NCP1117s.sch, can.sch, i2c0.sch, i2c1.sch, max.sch, spi.sch, yatagarasu-fit.sch]
2017-05-24 Added pcb image
2017-05-25 Replaced the image with after soldering components
2017-06-10 Fixed MCP2525 wrong package
    [Console.sch, NCP1117s.sch, can.sch, i2c0.sch, i2c1.sch, max.sch, spi.sch, yatagarasu-fit.sch]
2017-06-11 Deleted unnecessary backup files
    [Console.sch, NCP1117s.sch, can.sch, i2c0.sch, i2c1.sch, max.sch, spi.sch, yatagarasu-fit.sch]
2017-11-06 Updated schematic to improve compatibility with DB410C
    [yatagarasu-fit.sch]
2017-11-06 Updated images from the Kicad
2017-12-15 Improved the pin comatibility to match with other ardupilot project.
    [Console.sch, NCP1117s.sch, can.sch, i2c0.sch, i2c1.sch, max.sch, spi.sch, yatagarasu-fit.sch]
2017-12-16 Added a image when powered on.
2017-12-27 Added PCB layout image.
