DCoJA/yatagarasu-red/(notices)

Notices in the files:
max.sch:
Copyright (c) 2017 DroneWorks Inc.
All rights reserved.
Creative Commons (CC BY-SA 4.0)
